LooOnDevBrix/Drone/Hardware/Drone/jlcpcb/production_files/BOM-Drone.csv

Reference | Qty | Value | Footprint | JLC Part
C1,C2,C18,C22,C26,C29,C32,C34 | 8 | 10uF | Capacitor_SMD:C_0603_1608Metric_Pad1.08x0.95mm_HandSolder | C1691
C3,C6,C7,C8,C9,C10,C11,C13,C14,C15,C17,C19,C20,C21,C24,C25,C28,C30,C31,C33,C35,C38,C40,C42,C43,C44,C46,C47,C48,C49,C50,C51,C53,C54,C55,C56,C59,C60,C62,C63,C64,C66,C71,C75,C76,C77,C78 | 47 | 100nF | Capacitor_SMD:C_0402_1005Metric | C1525
C4,C5,C12,C74 | 4 | 10uF | Capacitor_SMD:C_0402_1005Metric | C15525
C16,C41 | 2 | 4.7uF | Capacitor_SMD:C_0402_1005Metric | C23733
C23 | 1 | 100uF | Capacitor_Tantalum_SMD:CP_EIA-3528-12_Kemet-T | C140381
C36,C37 | 2 | 12pF | Capacitor_SMD:C_0402_1005Metric | C26406
C39,C45,C65,C72 | 4 | 1uF | Capacitor_SMD:C_0402_1005Metric | C14445
C69,C70 | 2 | 10pF | Capacitor_SMD:C_0402_1005Metric | C1634
C73 | 1 | 10nF | Capacitor_SMD:C_0402_1005Metric | C57112
D1,D2,D3,D4 | 4 | 1N4148WT | Diode_SMD:D_SOD-523 | C68948
J1 | 1 | HC-05 | Connector_PinSocket_2.54mm:PinSocket_1x04_P2.54mm_Vertical | C2691448
J2,J15 | 2 | Conn_01x06 | Connector_PinHeader_2.54mm:PinHeader_2x03_P2.54mm_Vertical_SMD | C3294461
J4 | 1 | BAT | Library:CONN-SMD_P2.00_S2B-PH-SM4-TB-LF-SN | C295747
J5 | 1 | FTDT | Connector_PinHeader_2.54mm:PinHeader_1x06_P2.54mm_Vertical | C492405
J10 | 1 | DC1 | Library:CONN-SMD_P2.00_S2B-PH-SM4-TB-LF-SN | C295747
J11 | 1 | HC-SRF05 | Connector_PinSocket_2.54mm:PinSocket_1x04_P2.54mm_Vertical | C2691448
J12 | 1 | PMW3901 | Connector_PinSocket_2.54mm:PinSocket_1x04_P2.54mm_Vertical | C2691448
J14 | 1 | I2C | Connector_PinSocket_2.54mm:PinSocket_1x04_P2.54mm_Vertical | C2691448
J16 | 1 | DC2 | Library:CONN-SMD_P2.00_S2B-PH-SM4-TB-LF-SN | C295747
J17 | 1 | DC3 | Library:CONN-SMD_P2.00_S2B-PH-SM4-TB-LF-SN | C295747
J18 | 1 | DC4 | Library:CONN-SMD_P2.00_S2B-PH-SM4-TB-LF-SN | C295747
L1 | 1 | 1uH/XEL4030-102ME | Library:IND-SMD_L4.0-W4.0-A | C5441341
L2 | 1 | 10uH | Capacitor_SMD:C_0402_1005Metric | C910650
L3 | 1 | 47nH | Capacitor_SMD:C_0402_1005Metric | C22334
L4 | 1 | 0R | Inductor_SMD:L_0402_1005Metric | C122704
L5 | 1 | 20nH | Inductor_SMD:L_0402_1005Metric | C77124
LE2,LE4 | 2 | RED/0603 | IVS_FOOTPRINTS:LED_0603 | C2286
Q1,Q2,Q3,Q4 | 4 | SI2300 | IVS_FOOTPRINTS:SOT23-3 | C72271
R1,R8,R22,R23 | 4 | 100R | Resistor_SMD:R_0402_1005Metric | C25076
R2 | 1 | 1.15K | Library:R_0402_1005Metric | C29401
R3,R4,R5,R9,R15,R17,R18,R20,R21 | 9 | 10K | Resistor_SMD:R_0402_1005Metric | C25744
R6 | 1 | 100K | Library:R_0402_1005Metric | C25530
R7 | 1 | 3.57K | Library:R_0402_1005Metric | C137991
R10,R11 | 2 | 220R | Resistor_SMD:R_0402_1005Metric | C25091
R12 | 1 | 470R | Resistor_SMD:R_0402_1005Metric | C25167
R13 | 1 | 4K7 | Resistor_SMD:R_0402_1005Metric | C25900
R14 | 1 | 1K | Resistor_SMD:R_0402_1005Metric | C11702
R16 | 1 | 732K | Library:R_0402_1005Metric | C27016
SW1,SW2,SW3 | 3 | SW_Push | Button_Switch_SMD:SW_SPST_B3U-1000P | C231329
TP1,TP2,TP3,TP28,TP29,TP30,TP31,TP32,TP33 | 9 | TestPoint | Library:CONN-SMD_YTC1P-3015-01 | C5221293
TP41,TP42 | 2 | TestPoint | Connector_PinHeader_2.54mm:PinHeader_1x01_P2.54mm_Vertical | C492400
U1 | 1 | ICM-20948 | Library:QFN-24_L3.0-W3.0-P0.40-BL-EP | C726001
U2 | 1 | QMC5883P | Library:LGA-16_L3.0-W3.0-P0.50-BL_SQ | C2847467
U3 | 1 | BMP280 | Library:LGA-8_L2.5-W2.0-P0.65_AMP6127 | C83291
U4 | 1 | ATMEGA32U4-MU | Library:VQFN-44_L7.0-W7.0-P0.50-BL-EP5.2 | C112161
U5 | 1 | TS5A23159RSER | Library:UQFN-10_L2.0-W1.5-P0.50-BL-EP | C138710
U6 | 1 | TPS61023DRLR | Library:SOT-563_L1.6-W1.2-P0.50-LS1.6-BR | C919459
U7 | 1 | TPS7A91 | Package_DFN_QFN:Texas_S-PDSO-N10_EP1.2x2mm | C2878140
U8 | 1 | ESP32-C6_C5364646 | Library:QFN-40_L5.0-W5.0-P0.40-TL-EP3.3 | C5364646
U9,U10 | 2 | TCA9406DCUR | Library:VSSOP-8_L2.3-W2.0-P0.50-LS3.1-BL | C840107
U11 | 1 | ATGM336H-5N31 | Library:GPSM-SMD_ATGM336H-TR | C90770
U12 | 1 | TXB0104QPWRQ1 | Library:TSSOP-14_L5.0-W4.4-P0.65-LS6.4-BL | C527571
U13 | 1 | Ipex | IVS_FOOTPRINTS:IPEX_Antena_Connector | C2987682
U16 | 1 | AP2112K-1_8TRG1 | Library:SOT-25_L3.0-W1.6-P0.95-LS2.8-BL | C176944
Y1 | 1 | 16Mhz | Crystal:Crystal_SMD_2016-4Pin_2.0x1.6mm | C2682778
Y3 | 1 | 40MHz | Crystal:Crystal_SMD_2016-4Pin_2.0x1.6mm | C20885029
