LooOnDevBrix/Drone/Hardware/Drone/Drone.step

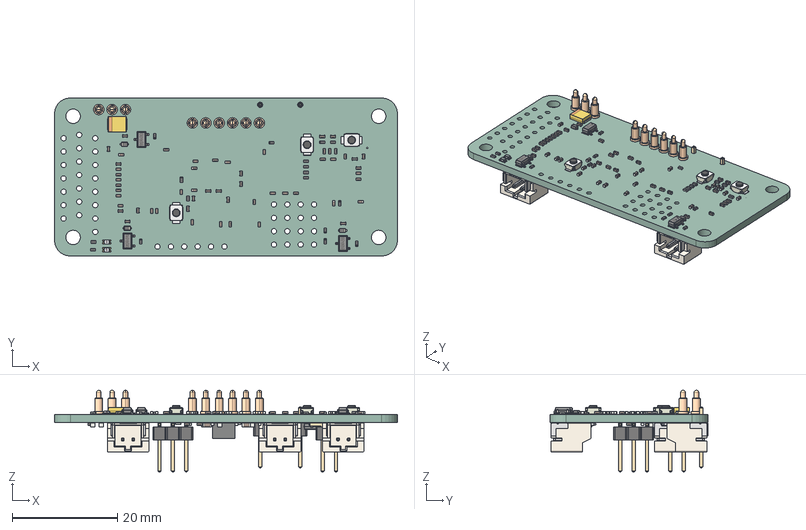
[picture p1: CAD file, 2026-11-09]
Hardware/Drone/Drone.step
65.1 x 30.0 x 15.5 mm
SOT23-3 x 4
CONN-SMD_YTC1P-3015-01 x 9
C_0402_1005Metric x 66
L_0402_1005Metric x 2
R_0402_1005Metric x 23
SW_SPST_B3U-1000P x 3
D_SOD-523 x 4
Light x 2
Anode Bottom x 2
Cathode Bottom x 2
Anode x 2
Cathode x 2
Base x 2
CP_EIA-3528-12_Kemet-T
CONN-SMD_P2.00_S2B-PH-SM4-TB-LF-SN x 5
C_0603_1608Metric x 8
PinHeader_2x03_P2.54mm_Vertical_SMD x 2
PinHeader_1x01_P2.54mm_Vertical x 2
Coilcraft-XGL4030
Drone_PCB
