LooOnDevBrix/Drone/(list of files, cad)

Other CAD files:
Hardware/Drone/jlcpcb/Drone.step
