LooOnDevBrix/Drone/Hardware/Drone/Drone.pdf

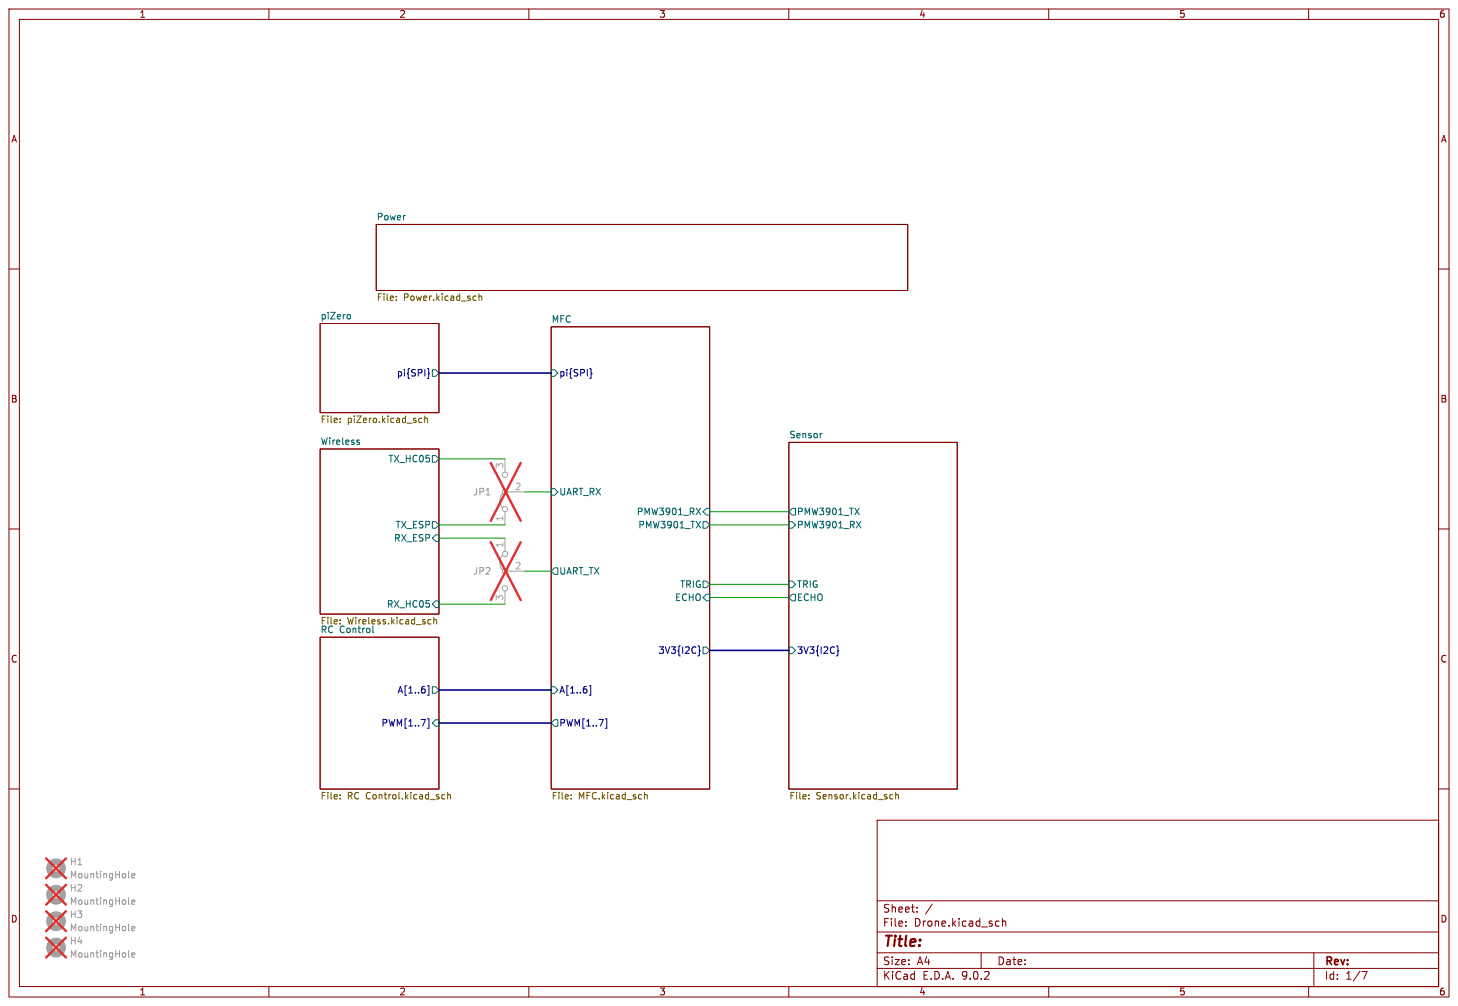
[picture p2: page 1]

JP2 H3 MountingHole H4 MountingHole H1 MountingHole H2 MountingHole

PWM[1..7] RC Control File: RC Control.kicad_sch

Id: 1/7 Title: File: Drone.kicad_sch Sheet: /
