LooOnDevBrix/Drone/Hardware/Drone/jlcpcb/Drone.pdf

JP2 H4 MountingHole H1 MountingHole H3 MountingHole H2 MountingHole

PWM[1..7] RC Control File: RC Control.kicad_sch

Id: 1/7 Title: File: Drone.kicad_sch Sheet: /

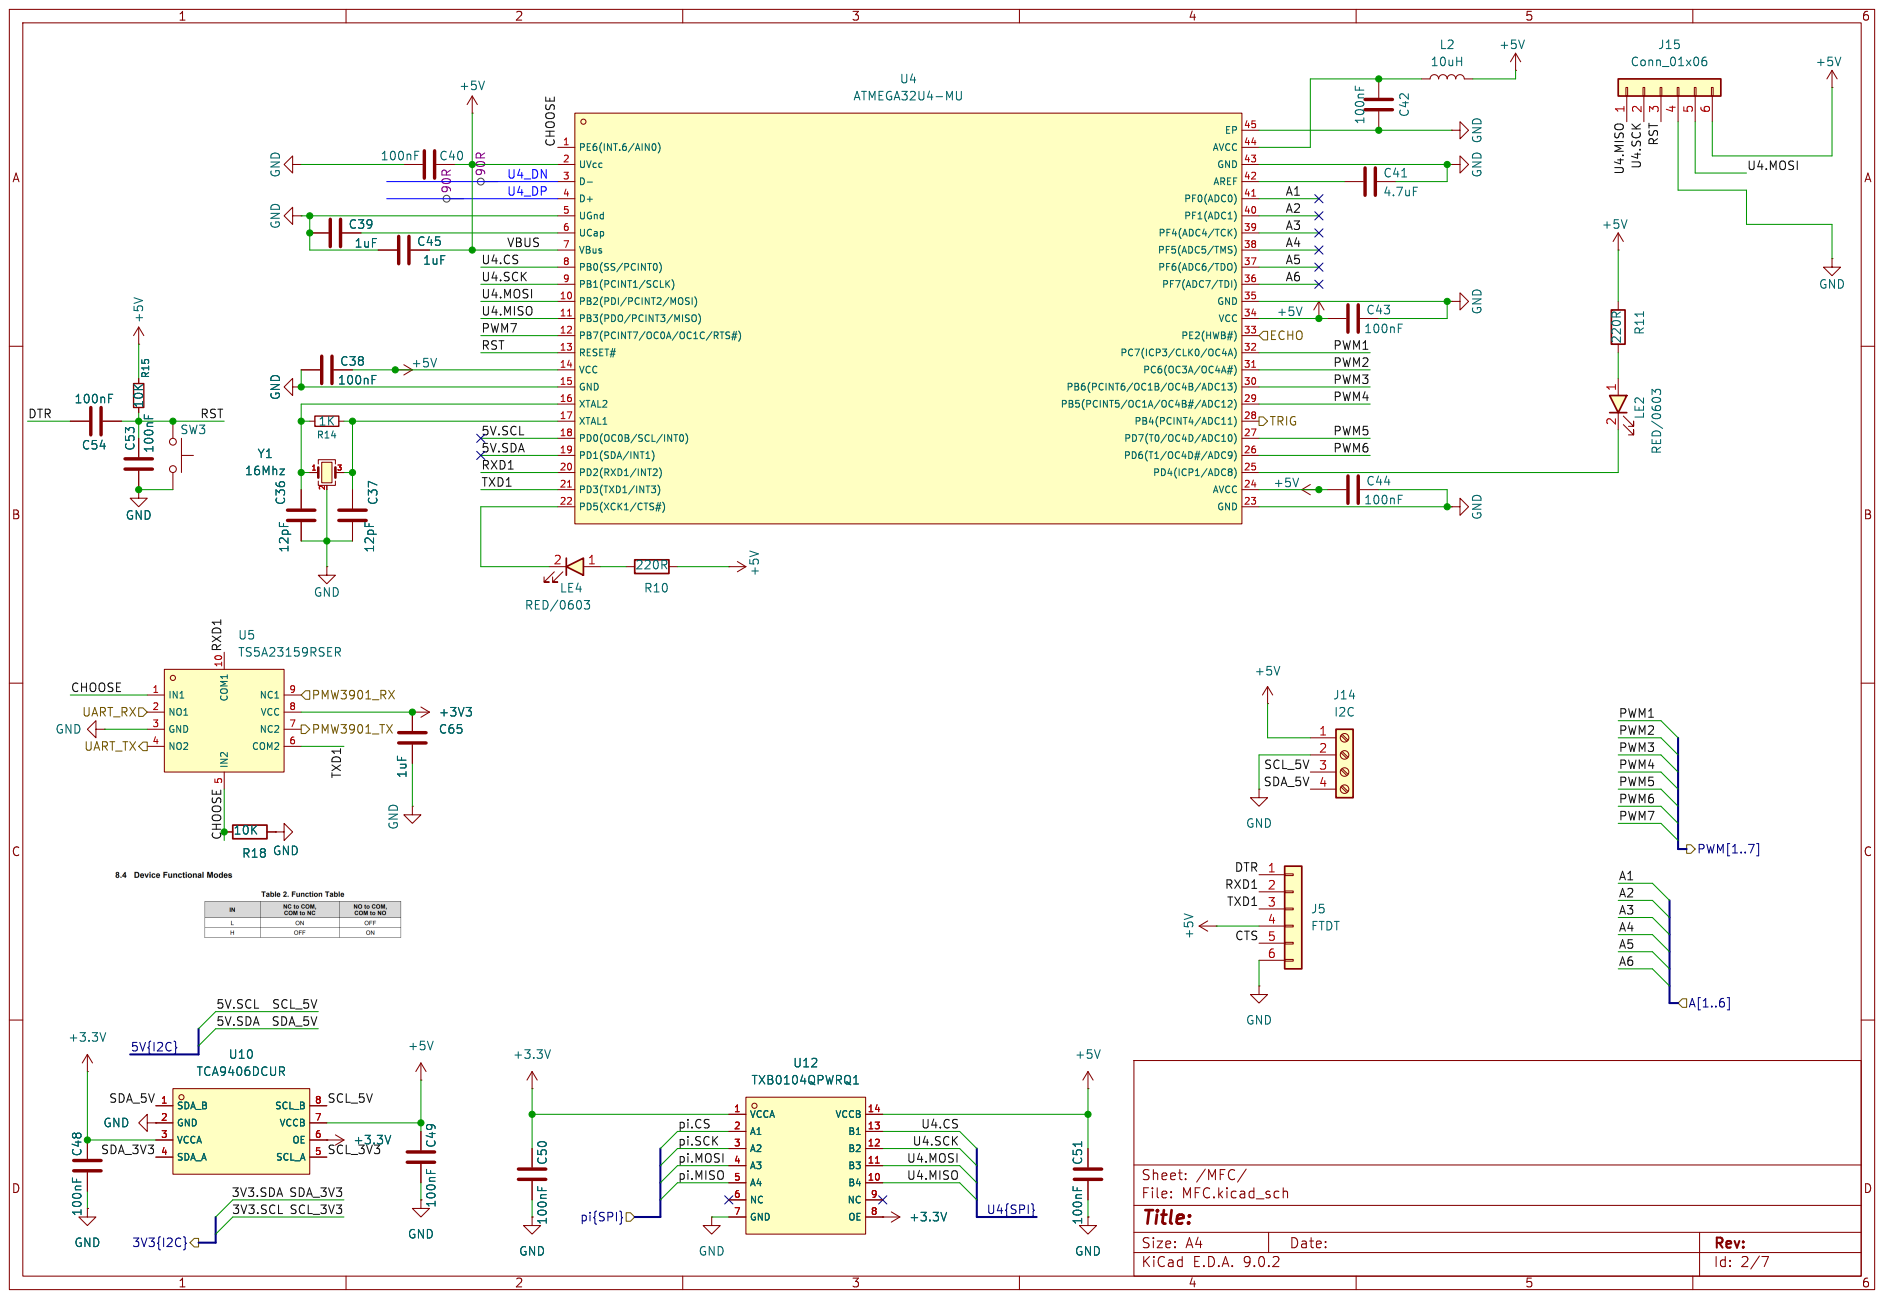
[picture p3: page 2]

Id: 2/7 Title: File: MFC.kicad_sch Sheet: /MFC/ R18

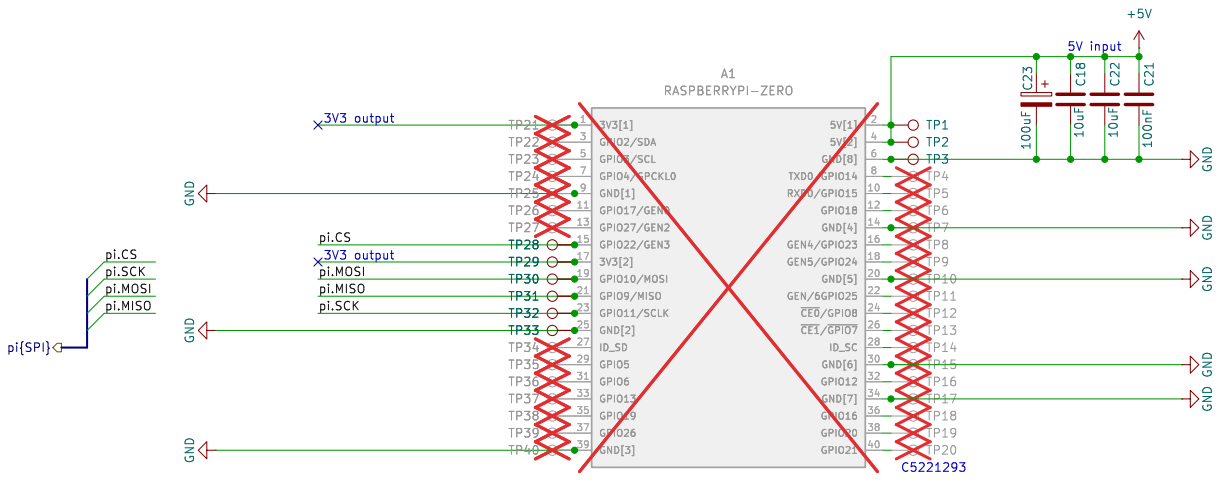
[picture p4: page 3]

Id: 3/7 Title: File: piZero.kicad_sch Sheet: /piZero/

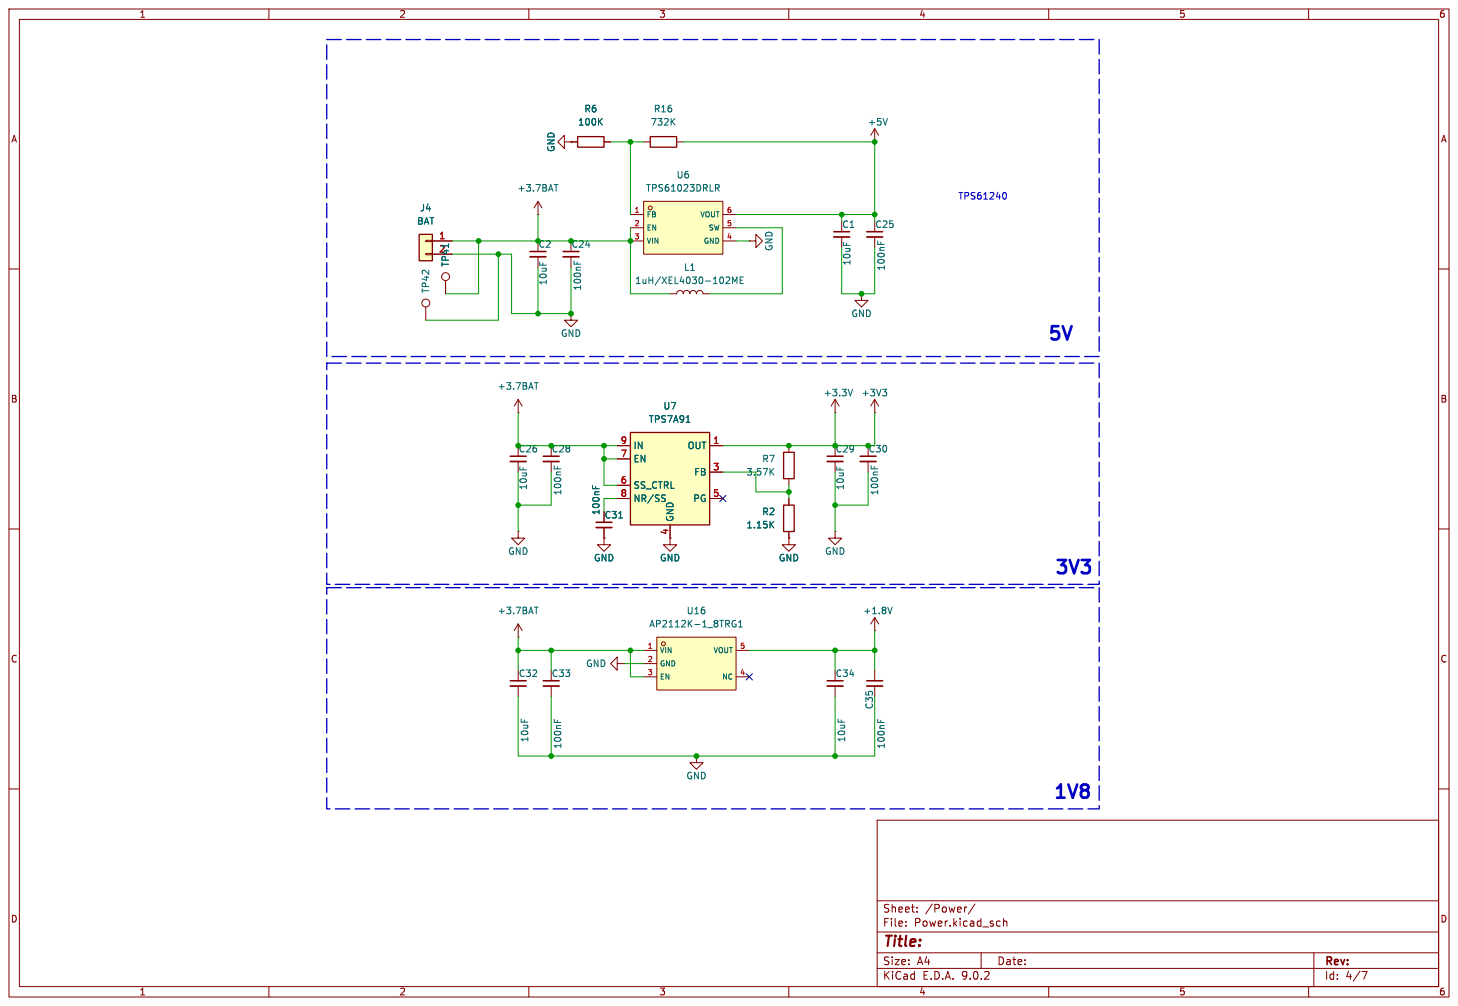
[picture p5: page 4]

Id: 4/7 Title: File: Power.kicad_sch Sheet: /Power/ C2610uF GND

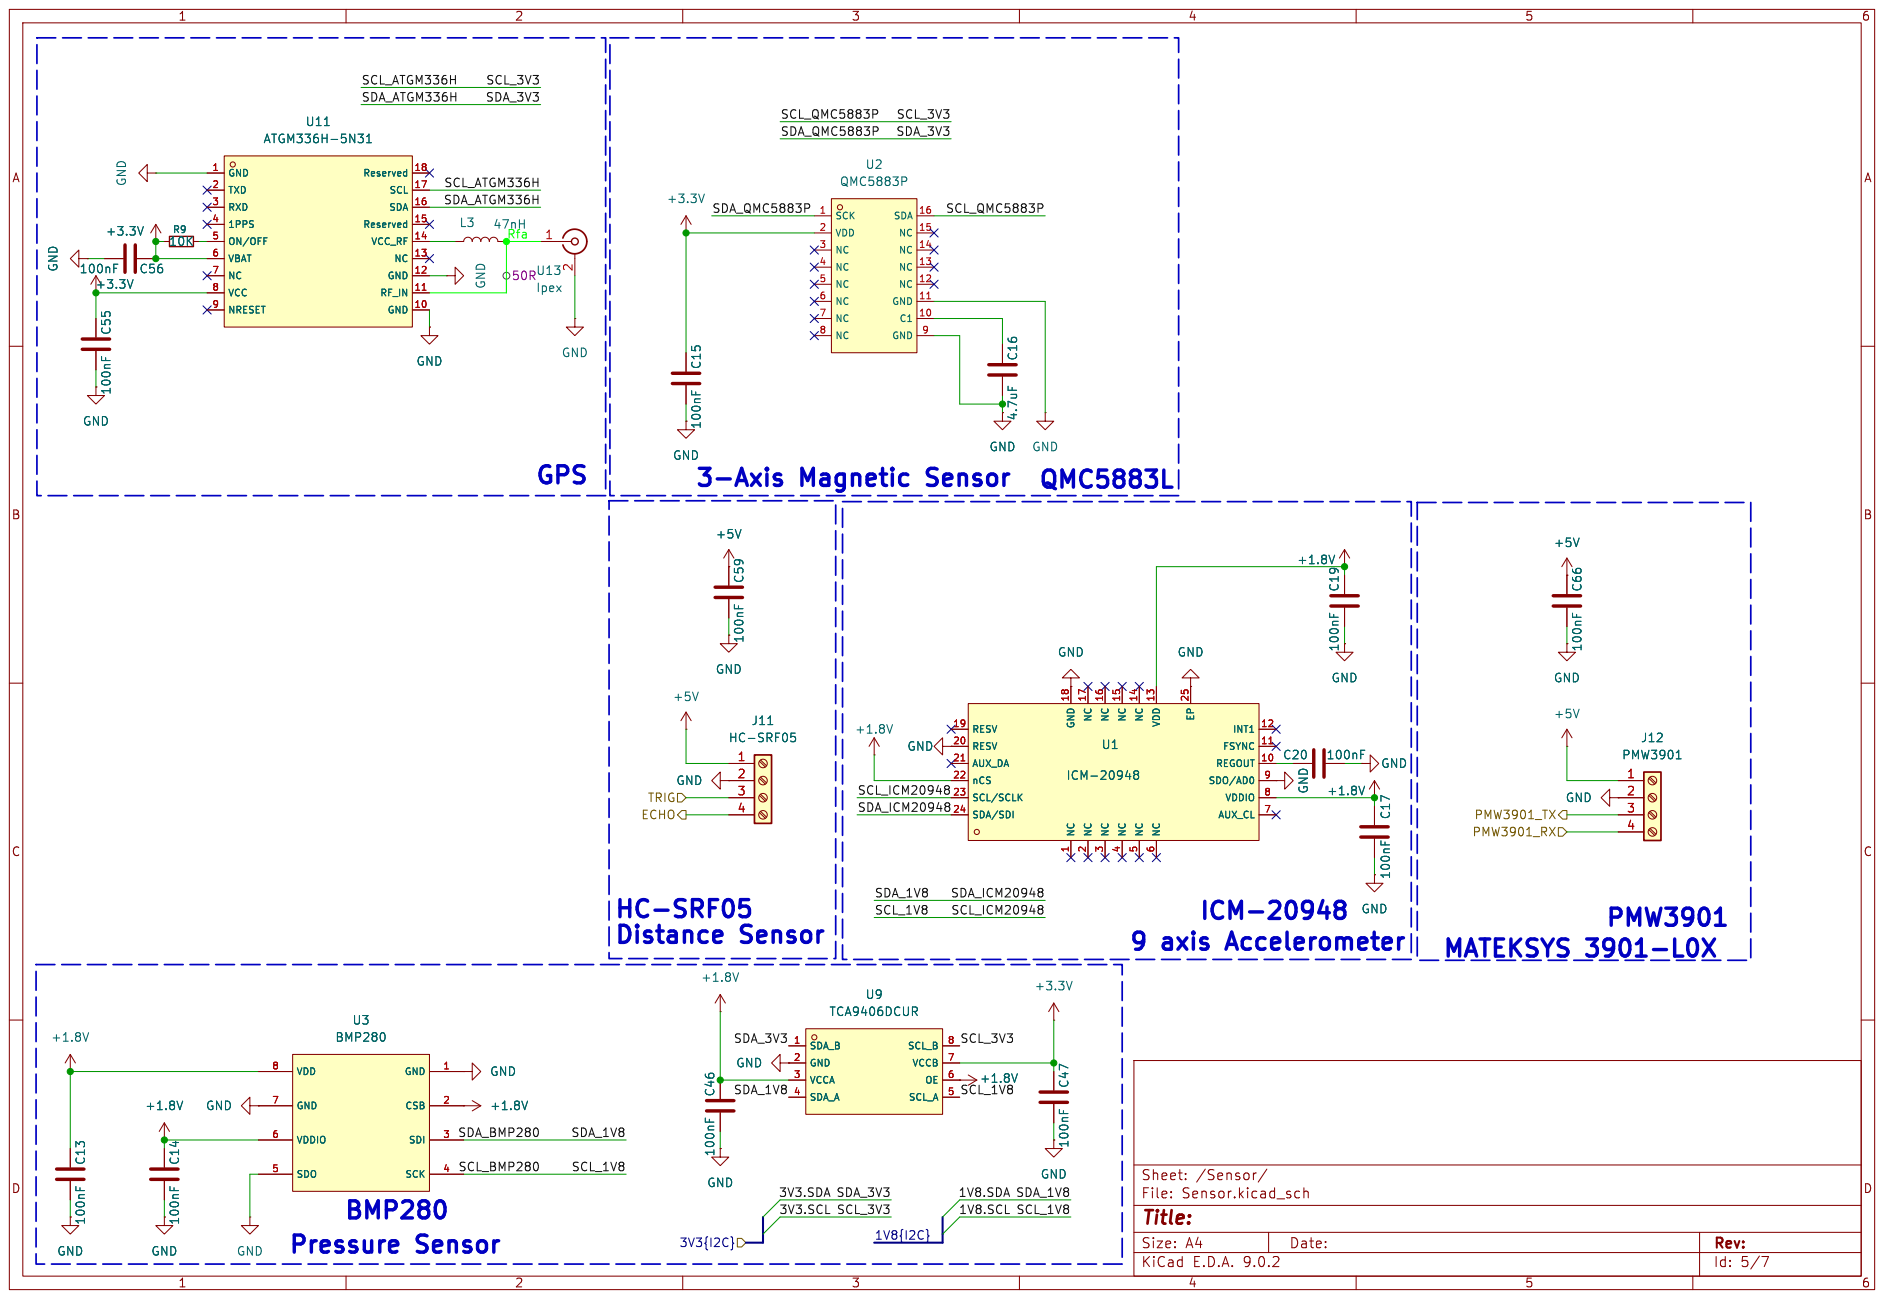
[picture p6: page 5]

6 SDA/SDI 24 AUX_CL 7 SCL/SCLK 23 VDDIO 8

Id: 5/7 Title: File: Sensor.kicad_sch Sheet: /Sensor/ +1.8V GND

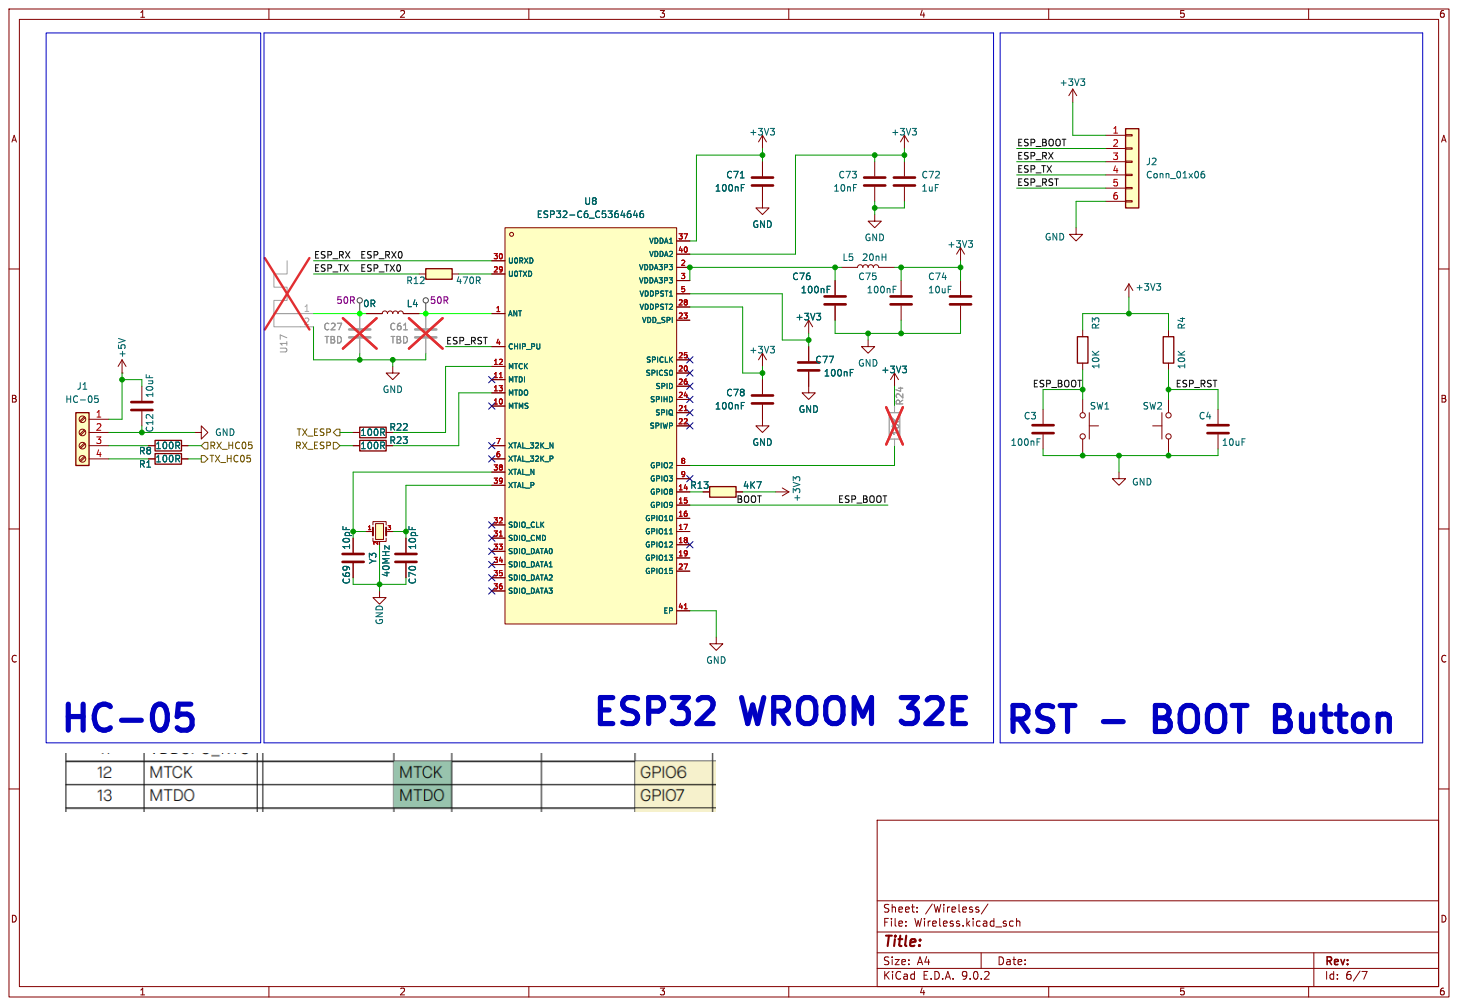
[picture p7: page 6]

Id: 6/7 Title: File: Wireless.kicad_sch Sheet: /Wireless/

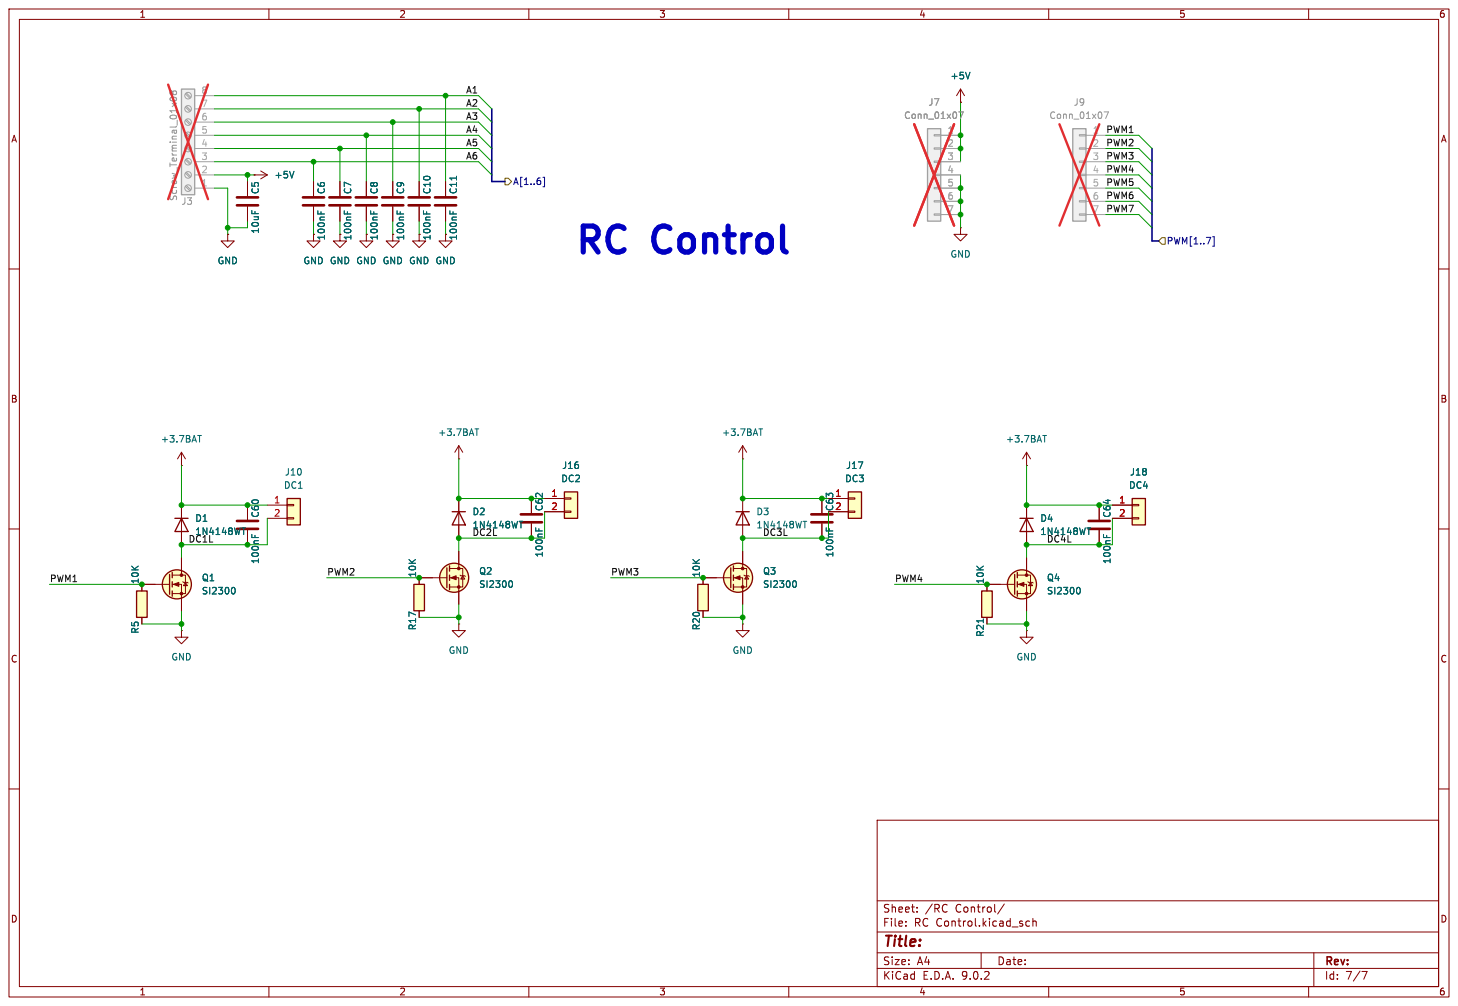
[picture p8: page 7]

Id: 7/7 Title: File: RC Control.kicad_sch Sheet: /RC Control/ D2
