LooOnDevBrix/Drone/Hardware/Drone/Drone.kicad_pcb

## KiCad design Hardware/Drone/Drone.kicad_pcb (2026-11-09)

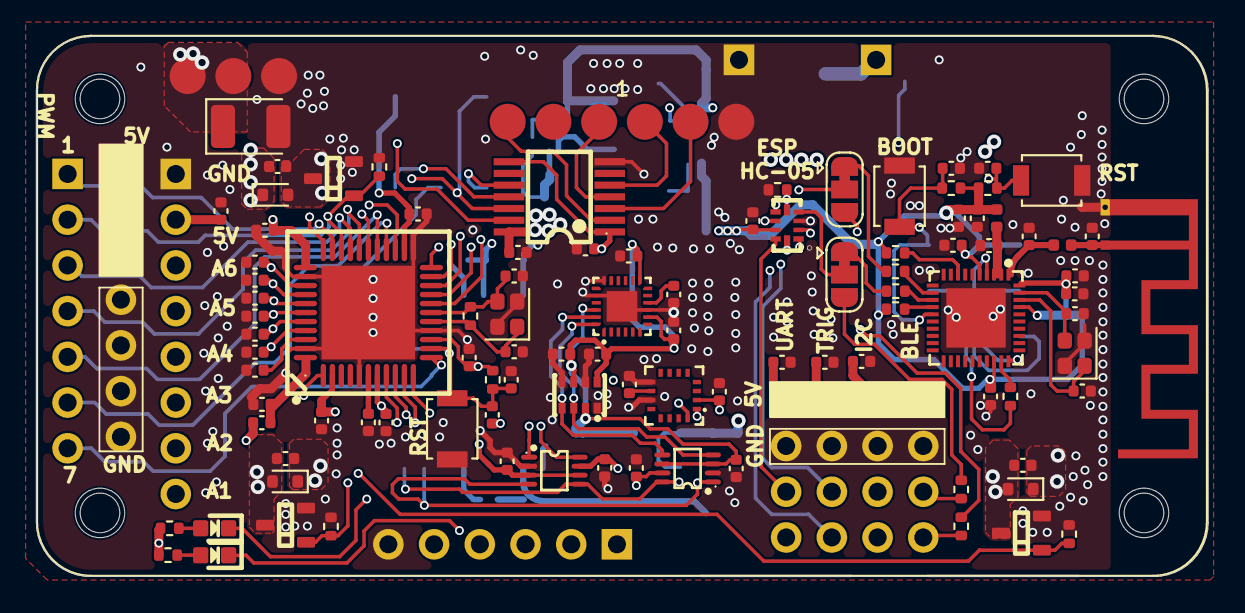
[picture p9: board Drone.kicad_pcb from above]

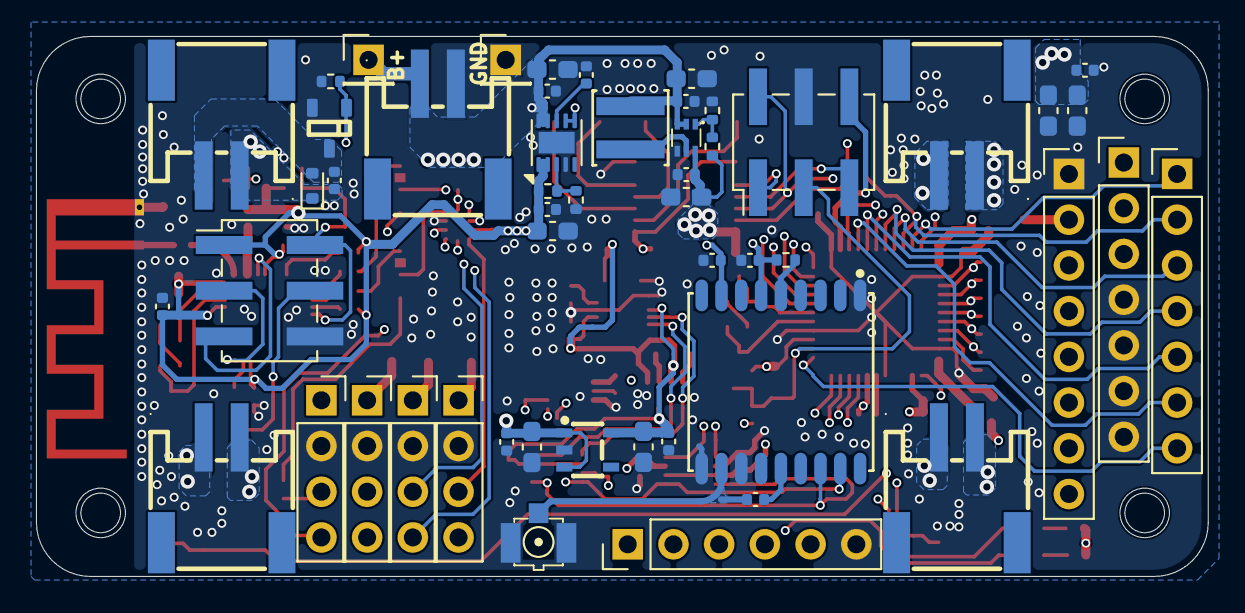
[picture p10: board Drone.kicad_pcb from below]

Board: 4 copper layers, 65.1 x 30.0 mm, 164 parts (52 on the bottom side), 85 nets.

Parts:
A1: RASPBERRYPI-ZERO; RASPBERRYPI-ZERO_RPI-ZERO
C1, C2, C18, C22, C26, C29, C32, C34: 10uF; C_0603_1608Metric_Pad1.08x0.95mm_HandSolder
C3, C6, C7, C8, C9, C10, C11, C13, C14, C15, C17, C19, C20, C21, C24, C25, C28, C30, C31, C33, C35, C38, C40, C42, C43, C44, C46, C47, C48, C49, C50, C51, C53, C54, C55, C56, C59, C60, C62, C63, C64, C66, C71, C75, C76, C77, C78: 100nF; C_0402_1005Metric
C4, C5, C12, C74: 10uF; C_0402_1005Metric
C16, C41: 4.7uF; C_0402_1005Metric
C23: 100uF; CP_EIA-3528-12_Kemet-T
C27, C61: TBD; C_0402_1005Metric
C36, C37: 12pF; C_0402_1005Metric
C39, C45, C65, C72: 1uF; C_0402_1005Metric
C69, C70: 10pF; C_0402_1005Metric
C73: 10nF; C_0402_1005Metric
D1, D2, D3, D4: 1N4148WT; D_SOD-523
H1, H2, H3, H4: MountingHole; MountingHole_2.2mm_M2
J1: HC-05; PinSocket_1x04_P2.54mm_Vertical
J2, J15: Conn_01x06; PinHeader_2x03_P2.54mm_Vertical_SMD
J3: Screw_Terminal_01x08; PinHeader_1x08_P2.54mm_Vertical
J4: BAT; CONN-SMD_P2.00_S2B-PH-SM4-TB-LF-SN
J5: FTDT; PinHeader_1x06_P2.54mm_Vertical
J7, J9: Conn_01x07; PinHeader_1x07_P2.54mm_Vertical
J10: DC1; CONN-SMD_P2.00_S2B-PH-SM4-TB-LF-SN
J11: HC-SRF05; PinSocket_1x04_P2.54mm_Vertical
J12: PMW3901; PinSocket_1x04_P2.54mm_Vertical
J14: I2C; PinSocket_1x04_P2.54mm_Vertical
J16: DC2; CONN-SMD_P2.00_S2B-PH-SM4-TB-LF-SN
J17: DC3; CONN-SMD_P2.00_S2B-PH-SM4-TB-LF-SN
J18: DC4; CONN-SMD_P2.00_S2B-PH-SM4-TB-LF-SN
JP1, JP2: Jumper_3_Bridged12; SolderJumper-3_P1.3mm_Bridged12_RoundedPad1.0x1.5mm
L1: 1uH/XEL4030-102ME; IND-SMD_L4.0-W4.0-A
L2: 10uH; C_0402_1005Metric
L3: 47nH; C_0402_1005Metric
L4: 0R; L_0402_1005Metric
L5: 20nH; L_0402_1005Metric
LE2, LE4: RED/0603; LED_0603
Q1, Q2, Q3, Q4: SI2300; SOT23-3
R1, R8, R22, R23: 100R; R_0402_1005Metric
R2: 1.15K; R_0402_1005Metric
R3, R4, R5, R9, R15, R17, R18, R20, R21, R24: 10K; R_0402_1005Metric
R6: 100K; R_0402_1005Metric
R7: 3.57K; R_0402_1005Metric
R10, R11: 220R; R_0402_1005Metric
R12: 470R; R_0402_1005Metric
R13: 4K7; R_0402_1005Metric
R14: 1K; R_0402_1005Metric
R16: 732K; R_0402_1005Metric
SW1, SW2, SW3: SW_Push; SW_SPST_B3U-1000P
TP1, TP2, TP3, TP28, TP29, TP30, TP31, TP32, TP33: TestPoint; CONN-SMD_YTC1P-3015-01
TP41, TP42: TestPoint; PinHeader_1x01_P2.54mm_Vertical
U1: ICM-20948; QFN-24_L3.0-W3.0-P0.40-BL-EP
U2: QMC5883P; LGA-16_L3.0-W3.0-P0.50-BL_SQ
U3: BMP280; LGA-8_L2.5-W2.0-P0.65_AMP6127
U4: ATMEGA32U4-MU; VQFN-44_L7.0-W7.0-P0.50-BL-EP5.2
U5: TS5A23159RSER; UQFN-10_L2.0-W1.5-P0.50-BL-EP
U6: TPS61023DRLR; SOT-563_L1.6-W1.2-P0.50-LS1.6-BR
U7: TPS7A91; Texas_S-PDSO-N10_EP1.2x2mm
U8: ESP32-C6_C5364646; QFN-40_L5.0-W5.0-P0.40-TL-EP3.3
U9, U10: TCA9406DCUR; VSSOP-8_L2.3-W2.0-P0.50-LS3.1-BL
U11: ATGM336H-5N31; GPSM-SMD_ATGM336H-TR
U12: TXB0104QPWRQ1; TSSOP-14_L5.0-W4.4-P0.65-LS6.4-BL
U13: Ipex; IPEX_Antena_Connector
U16: AP2112K-1_8TRG1; SOT-25_L3.0-W1.6-P0.95-LS2.8-BL
U17: Texas_SWRA117D_2.4GHz_Right
Y1: 16Mhz; Crystal_SMD_2016-4Pin_2.0x1.6mm
Y3: 40MHz; Crystal_SMD_2016-4Pin_2.0x1.6mm

Connections:
+1.8V: C13.1, C14.1, C17.1, C19.1, C34.1, C35.1, C46.1, U1.8 (VDDIO), U1.13 (VDD), U1.22 (nCS), U3.2 (CSB), U3.6 (VDDIO), U3.8 (VDD), U9.3 (VCCA), U9.6 (OE), U16.5 (VOUT)
+3.3V: C15.1, C29.1, C30.1, C47.1, C48.1, C50.1, C55.1, C56.1, C65.1, C71.1, C72.1, C73.1, C74.1, C75.1, C77.1, C78.1, J2.1, L5.2, R3.1, R4.1, R7.2, R9.1, R13.1, R24.1, U2.2 (VDD), U5.8 (VCC), U7.1 (OUT), U7.2 (OUT), U8.5 (VDDPST1), U8.28 (VDDPST2), U8.37 (VDDA1), U8.40 (VDDA2), U9.7 (VCCB), U10.3 (VCCA), U10.6 (OE), U11.6 (VBAT), U11.8 (VCC), U12.1 (VCCA), U12.8 (OE)
+3.7BAT: C2.1, C24.1, C26.1, C28.1, C32.1, C33.1, C60.1, C62.1, C63.1, C64.1, D1.1 (K), D2.1 (K), D3.1 (K), D4.1 (K), J4.1, J10.1, J16.1, J17.1, J18.1, L1.1, TP41.1, U6.2 (EN), U6.3 (VIN), U7.6 (SS_CTRL), U7.7 (EN), U7.9 (IN), U7.10 (IN), U16.1 (VIN), U16.3 (EN)
+5V: A1.2 (5V[1]), A1.4 (5V[2]), C1.1, C5.1, C12.2, C18.1, C21.1, C22.1, C23.1, C25.1, C38.1, C40.2, C43.2, C44.2, C45.1, C49.1, C51.1, C59.1, C66.1, J1.1, J3.2, J5.4, J7.1, J7.2, J7.3, J11.1, J12.1, J14.1, J15.6, L2.2, R10.1, R11.1, R15.1, R16.2, TP1.1, TP2.1, U4.2 (UVcc), U4.7 (VBus), U4.14 (VCC), U4.24 (AVCC), U4.34 (VCC), U6.6 (VOUT), U10.7 (VCCB), U12.14 (VCCB)
/MFC/3V3.SCL: U2.16 (SDA), U9.8 (SCL_B), U10.5 (SCL_A), U11.17 (SCL)
/MFC/3V3.SDA: U2.1 (SCK), U9.1 (SDA_B), U10.4 (SDA_A), U11.16 (SDA)
/MFC/5V.SCL: J14.3, U4.18 (PD0(OC0B/SCL/INT0)), U10.8 (SCL_B)
/MFC/5V.SDA: J14.4, U4.19 (PD1(SDA/INT1)), U10.1 (SDA_B)
/MFC/A1: C11.1, J3.8, U4.41 (PF0(ADC0))
/MFC/A2: C10.1, J3.7, U4.40 (PF1(ADC1))
/MFC/A3: C9.1, J3.6, U4.39 (PF4(ADC4/TCK))
/MFC/A4: C8.1, J3.5, U4.38 (PF5(ADC5/TMS))
/MFC/A5: C7.1, J3.4, U4.37 (PF6(ADC6/TDO))
/MFC/A6: C6.1, J3.3, U4.36 (PF7(ADC7/TDI))
/MFC/CHOOSE: R18.2, U4.1 (PE6(INT.6/AIN0)), U5.1 (IN1), U5.5 (IN2)
/MFC/DTR: C54.1, J5.1
/MFC/ECHO: J11.4, U4.33 (PE2(HWB#))
/MFC/PMW3901_RX: J12.3, U5.9 (NC1)
/MFC/PMW3901_TX: J12.4, U5.7 (NC2)
/MFC/PWM1: J9.1, Q1.1 (G), R5.1, U4.32 (PC7(ICP3/CLK0/OC4A))
/MFC/PWM2: J9.2, Q2.1 (G), R17.1, U4.31 (PC6(OC3A/OC4A#))
/MFC/PWM3: J9.3, Q3.1 (G), R20.1, U4.30 (PB6(PCINT6/OC1B/OC4B/ADC13))
/MFC/PWM4: J9.4, Q4.1 (G), R21.1, U4.29 (PB5(PCINT5/OC1A/OC4B#/ADC12))
/MFC/PWM5: J9.5, U4.27 (PD7(T0/OC4D/ADC10))
/MFC/PWM6: J9.6, U4.26 (PD6(T1/OC4D#/ADC9))
/MFC/PWM7: J9.7, U4.12 (PB7(PCINT7/OC0A/OC1C/RTS#))
/MFC/RST: C53.1, C54.2, J15.3, R15.2, SW3.2, U4.13 (RESET#)
/MFC/RXD1: J5.2, U4.20 (PD2(RXD1/INT2)), U5.10 (COM1)
/MFC/TRIG: J11.3, U4.28 (PB4(PCINT4/ADC11))
/MFC/TXD1: J5.3, U4.21 (PD3(TXD1/INT3)), U5.6 (COM2)
/MFC/U4.CS: U4.8 (PB0(SS/PCINT0)), U12.13 (B1)
/MFC/U4.MISO: J15.1, U4.11 (PB3(PDO/PCINT3/MISO)), U12.10 (B4)
/MFC/U4.MOSI: J15.5, U4.10 (PB2(PDI/PCINT2/MOSI)), U12.11 (B3)
/MFC/U4.SCK: J15.2, U4.9 (PB1(PCINT1/SCLK)), U12.12 (B2)
/MFC/UART_RX: JP1.2 (C), U5.2 (NO1)
/MFC/UART_TX: JP2.2 (C), U5.4 (NO2)
/MFC/pi.CS: A1.15 (GPIO22/GEN3), TP28.1, U12.2 (A1)
/MFC/pi.MISO: A1.21 (GPIO9/MISO), TP31.1, U12.5 (A4)
/MFC/pi.MOSI: A1.19 (GPIO10/MOSI), TP30.1, U12.4 (A3)
/MFC/pi.SCK: A1.23 (GPIO11/SCLK), TP32.1, U12.3 (A2)
/RC Control/DC1L: C60.2, D1.2 (A), J10.2, Q1.3 (D)
/RC Control/DC2L: C62.2, D2.2 (A), J16.2, Q2.3 (D)
/RC Control/DC3L: C63.2, D3.2 (A), J17.2, Q3.3 (D)
/RC Control/DC4L: C64.2, D4.2 (A), J18.2, Q4.3 (D)
/Sensor/1V8.SCL: U1.23 (SCL/SCLK), U3.4 (SCK), U9.5 (SCL_A)
/Sensor/1V8.SDA: U1.24 (SDA/SDI), U3.3 (SDI), U9.4 (SDA_A)
/Sensor/Rfa: L3.2, U11.11 (RF_IN), U13.1
/Wireless/BOOT: C3.1, J2.2, R3.2, SW1.1, U8.15 (GPIO9)
/Wireless/ESP_RST: C4.1, J2.5, R4.2, SW2.2, U8.4 (CHIP_PU)
/Wireless/ESP_RX: J2.3, U8.30 (U0RXD)
/Wireless/ESP_TX: J2.4, R12.2
/Wireless/RX_ESP: JP2.1 (A), R23.2
/Wireless/RX_HC05: JP2.3 (B), R8.2
/Wireless/TX_ESP: JP1.1 (A), R22.2
/Wireless/TX_HC05: JP1.3 (B), R1.2
GND: A1.6 (GND[8]), A1.25 (GND[2]), C1.2, C2.2, C3.2, C4.2, C5.2, C6.2, C7.2, C8.2, C9.2, C10.2, C11.2, C12.1, C13.2, C14.2, C15.2, C16.2, C17.2, C18.2, C19.2, C20.2, C21.2, C22.2, C23.2, C24.2, C25.2, C26.2, C27.2, C28.2, C29.2, C30.2, C31.2, C32.2, C33.2, C34.2, C35.2, C36.2, C37.2, C38.2, C39.2, C40.1, C41.1, C42.1, C43.1, C44.1, C45.2, C46.2, C47.2, C48.2, C49.2, C50.2, C51.2, C53.2, C55.2, C56.2, C59.2, C61.2, C65.2, C66.2, C69.2, C70.2, C71.2, C72.2, C73.2, C74.2, C75.2, C76.2, C77.2, C78.2, J1.2, J2.6, J3.1, J4.2, J5.6, J7.4, J7.5, J7.6, J7.7, J11.2, J12.2, J14.2, J15.4, Q1.2 (S), Q2.2 (S), Q3.2 (S), Q4.2 (S), R2.1, R5.2, R6.1, R17.2, R18.1, R20.2, R21.2, SW1.2, SW2.1, SW3.1, TP3.1, TP33.1, TP42.1, U1.9 (SDO/AD0), U1.18 (GND), U1.20 (RESV), U1.25 (EP), U2.9 (GND), U2.11 (GND), U3.1 (GND), U3.5 (SDO), U3.7 (GND), U4.5 (UGnd), U4.15 (GND), U4.23 (GND), U4.35 (GND), U4.43 (GND), U4.45 (EP), U5.3 (GND), U6.4 (GND), U7.4 (GND), U7.11 (GND), U8.41 (EP), U9.2 (GND), U10.2 (GND), U11.1 (GND), U11.10 (GND), U11.12 (GND), U12.7 (GND), U13.2, U16.2 (GND), U17.2, Y1.2, Y1.4, Y3.2, Y3.4
unnamed: C27.1, L4.2, U17.1
unnamed: C42.2, L2.1, U4.44 (AVCC)
unnamed: C76.1, L5.1, U8.2 (VDDA3P3), U8.3 (VDDA3P3)
unnamed: J1.3, R8.1
unnamed: J1.4, R1.1
unnamed: LE2.1, R11.2
unnamed: LE4.1, R10.2
unnamed: C20.1, U1.10 (REGOUT)
unnamed: C16.1, U2.10 (C1)
unnamed: C41.2, U4.42 (AREF)
unnamed: LE2.2, U4.25 (PD4(ICP1/ADC8))
unnamed: LE4.2, U4.22 (PD5(XCK1/CTS#))
unnamed: C39.1, U4.6 (UCap)
unnamed: C37.1, R14.2, U4.17 (XTAL1), Y1.3
unnamed: C36.1, R14.1, U4.16 (XTAL2), Y1.1
unnamed: R6.2, R16.1, U6.1 (FB)
unnamed: L1.2, U6.5 (SW)
unnamed: R2.2, R7.1, U7.3 (FB)
unnamed: C31.1, U7.8 (NR/SS)
unnamed: C61.1, L4.1, U8.1 (ANT)
unnamed: R24.2, U8.8 (GPIO2)
unnamed: R13.2, U8.14 (GPIO8)
unnamed: R22.1, U8.12 (MTCK)
unnamed: R23.1, U8.13 (MTDO)
unnamed: R12.1, U8.29 (U0TXD)
unnamed: C69.1, U8.38 (XTAL_N), Y3.1
unnamed: C70.1, U8.39 (XTAL_P), Y3.3
unnamed: R9.2, U11.5 (ON/OFF)
unnamed: L3.1, U11.14 (VCC_RF)
